jimg46/OAT_xtras/README.md

# OAT_xtras
OpenAstroTracker bits and pieces
