jimg46/OAT_xtras/OAT_xtras/barmount_v2.stl

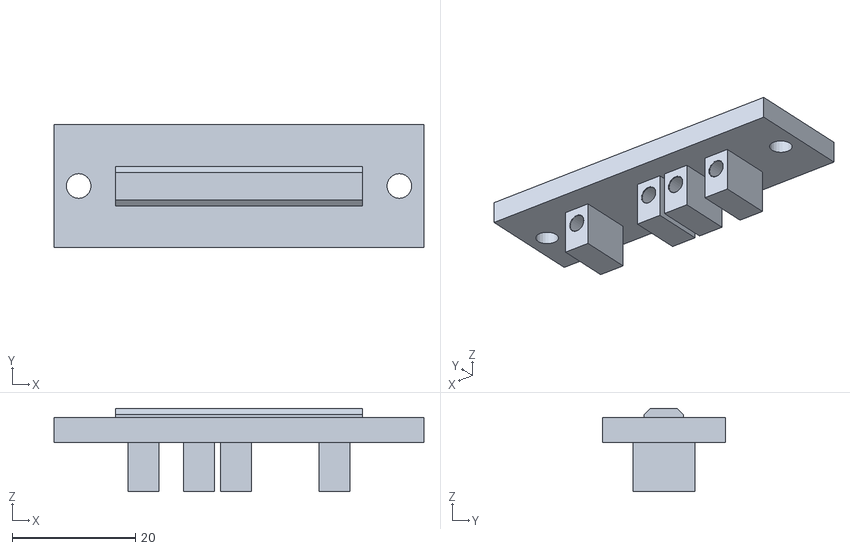
[picture p1: CAD file, 2021-03-11]
OAT_xtras/barmount_v2.stl
60.0 x 20.0 x 13.5
