jimg46/OAT_xtras/OAT_xtras/2020parallel_level.stl

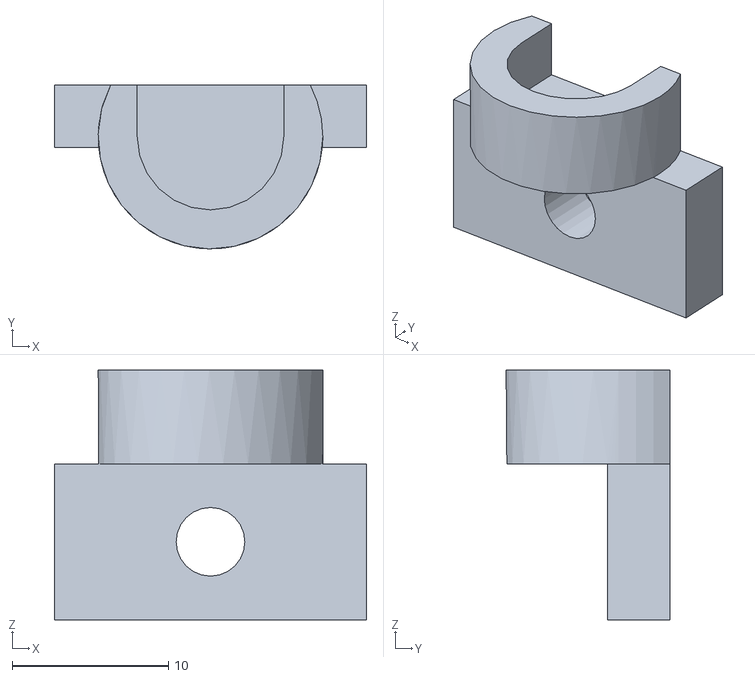
[picture p2: CAD file, 2021-03-11]
OAT_xtras/2020parallel_level.stl
20.0 x 10.5 x 16.0
