jimg46/OAT_xtras/OAT_xtras/RAstop.stl

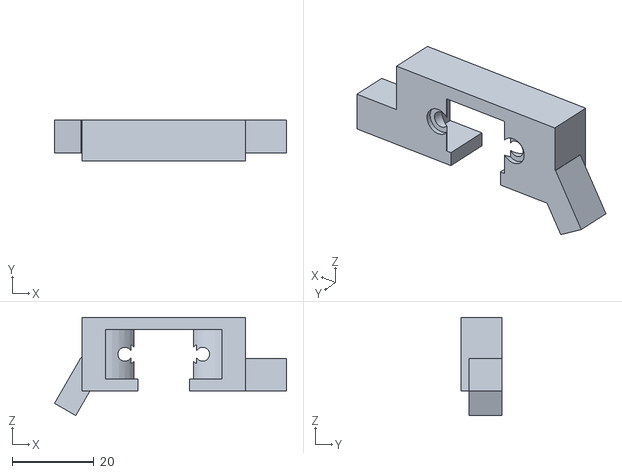
[picture p3: CAD file, 2021-03-11]
OAT_xtras/RAstop.stl
56.7 x 10.0 x 24.0
