jimg46/OAT_xtras/OAT_xtras/2020cross_level.stl

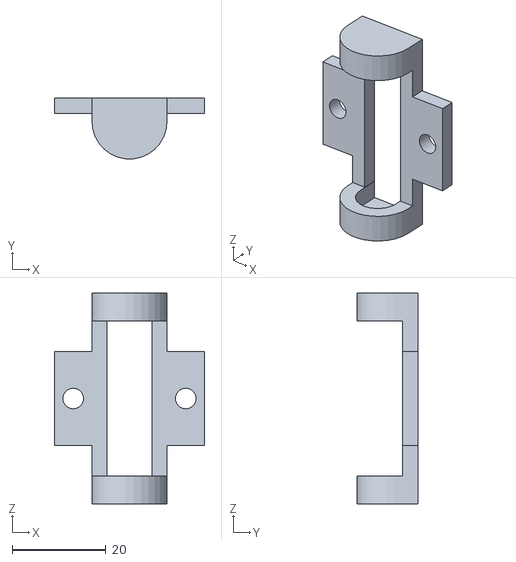
[picture p4: CAD file, 2021-03-11]
OAT_xtras/2020cross_level.stl
32.0 x 13.0 x 45.0
