jimg46/OAT_xtras/OAT_xtras/DEC_stop_arm.stl

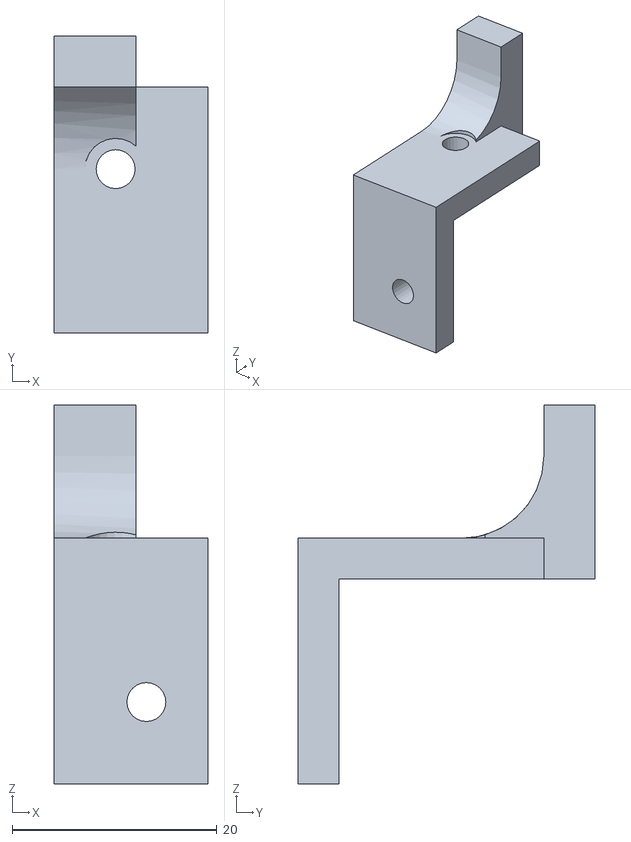
[picture p5: CAD file, 2021-03-11]
OAT_xtras/DEC_stop_arm.stl
15.0 x 29.0 x 37.0
