jimg46/OAT_xtras/EAGLE/ESPOAT.brd

## EAGLE design EAGLE/ESPOAT.brd (2021-03-11)

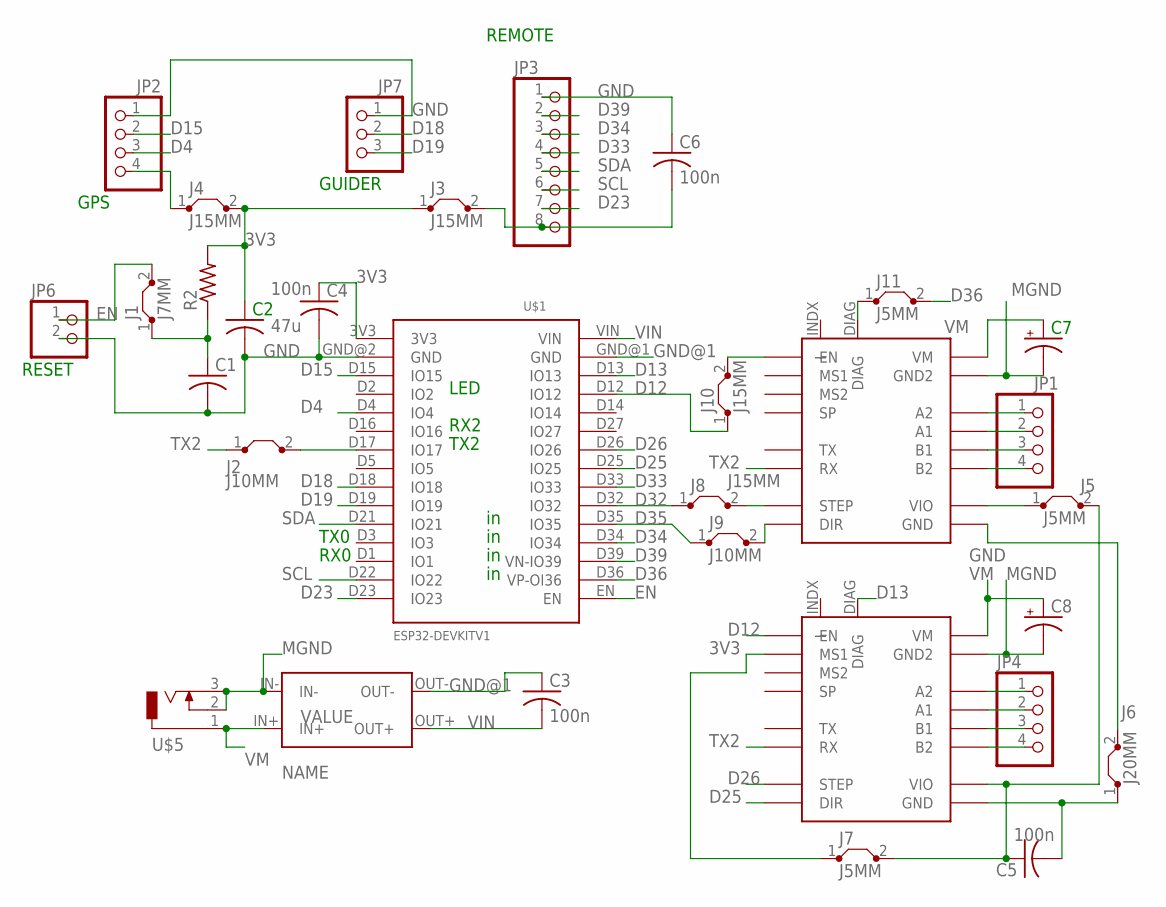
[picture p6: schematic ESPOAT.sch]

Parts:
C1: C-US025-030X050; C025-030X050
C2: 47u; C050-024X044
C3, C4, C5, C6: 100n; C050-024X044
C7, C8: CPOL-USE5-8.5; E5-8,5
J1: J7MM; 07
J2, J9: J10MM; 10
J3, J4, J8, J10: J15MM; 15
J5, J7, J11: J5MM; 05
J6: J20MM; 20
JP1, JP2, JP4: PINHD-1X4; 1X04
JP3: PINHD-1X8; 1X08
JP6: PINHD-1X2; 1X02
JP7: PINHD-1X3; 1X03
R2: R-US_0207/10; 0207/10
U$1: ESP32DEVKITV1; ESP32-DEVKITV1
U$2, U$3: FY2209V3
U$4: MINI-360
U$5: PS0520; DCJ0203

Connections:
3V3: C2.1, C4.1, J3.1, J4.2, J7.1, R2.2, U$1.3V3, U$3.MS1
D4: JP2.3, U$1.D4 (IO4)
D12: J10.1, U$1.D12 (IO12), U$3.EN
D13: U$1.D13 (IO13), U$3.DIAG
D15: JP2.2, U$1.D15 (IO15)
D18: JP7.2, U$1.D18 (IO18)
D19: JP7.3, U$1.D19 (IO19)
D23: JP3.7, U$1.D23 (IO23)
D25: U$1.D25 (IO25), U$3.DIR
D26: U$1.D26 (IO26), U$3.STP (STEP)
D32: J8.1, U$1.D32 (IO32)
D33: JP3.4, U$1.D33 (IO33)
D34: JP3.3, U$1.D34 (IO34)
D35: J9.1, U$1.D35 (IO35)
D36: J11.2, U$1.D36 (VP-OI36)
D39: JP3.2, U$1.D39 (VN-IO39)
EN: J1.2, JP6.1, U$1.EN
GND: C1.2, C2.2, C4.2, C6.1, J6.2, JP2.1, JP3.1, JP6.2, JP7.1, U$1.GND@2 (GND), U$2.GND
GND@1: C3.1, U$1.GND@1 (GND), U$4.OUT-
MGND: C7.-, C8.-, U$2.GND2, U$3.GND2, U$4.IN-, U$5.2, U$5.3
unnamed: JP1.4, U$2.B2
unnamed: J8.2, U$2.STP (STEP)
unnamed: C1.1, J1.1, R2.1
unnamed: J2.2, U$1.D17 (IO17)
unnamed: JP1.3, U$2.B1
unnamed: C5.1, J5.2, J7.2, U$3.VIO
unnamed: J4.1, JP2.4
unnamed: J5.1, U$2.VIO
unnamed: C5.2, J6.1, U$3.GND
unnamed: J9.2, U$2.DIR
unnamed: J10.2, U$2.EN
unnamed: JP1.2, U$2.A1
unnamed: JP1.1, U$2.A2
unnamed: JP4.1, U$3.A2
unnamed: JP4.2, U$3.A1
unnamed: JP4.3, U$3.B1
unnamed: JP4.4, U$3.B2
unnamed: J11.1, U$2.DIAG
unnamed: C6.2, J3.2, JP3.8
SCL: JP3.6, U$1.D22 (IO22)
SDA: JP3.5, U$1.D21 (IO21)
TX2: J2.1, U$2.RX, U$3.RX
VIN: C3.2, U$1.VIN, U$4.OUT+
VM: C7.+, C8.+, U$2.VM, U$3.VM, U$4.IN+, U$5.1

Notes on the sheet:
LED
TX0
RX0
REMOTE
GPS
RESET
GUIDER
TX2
RX2

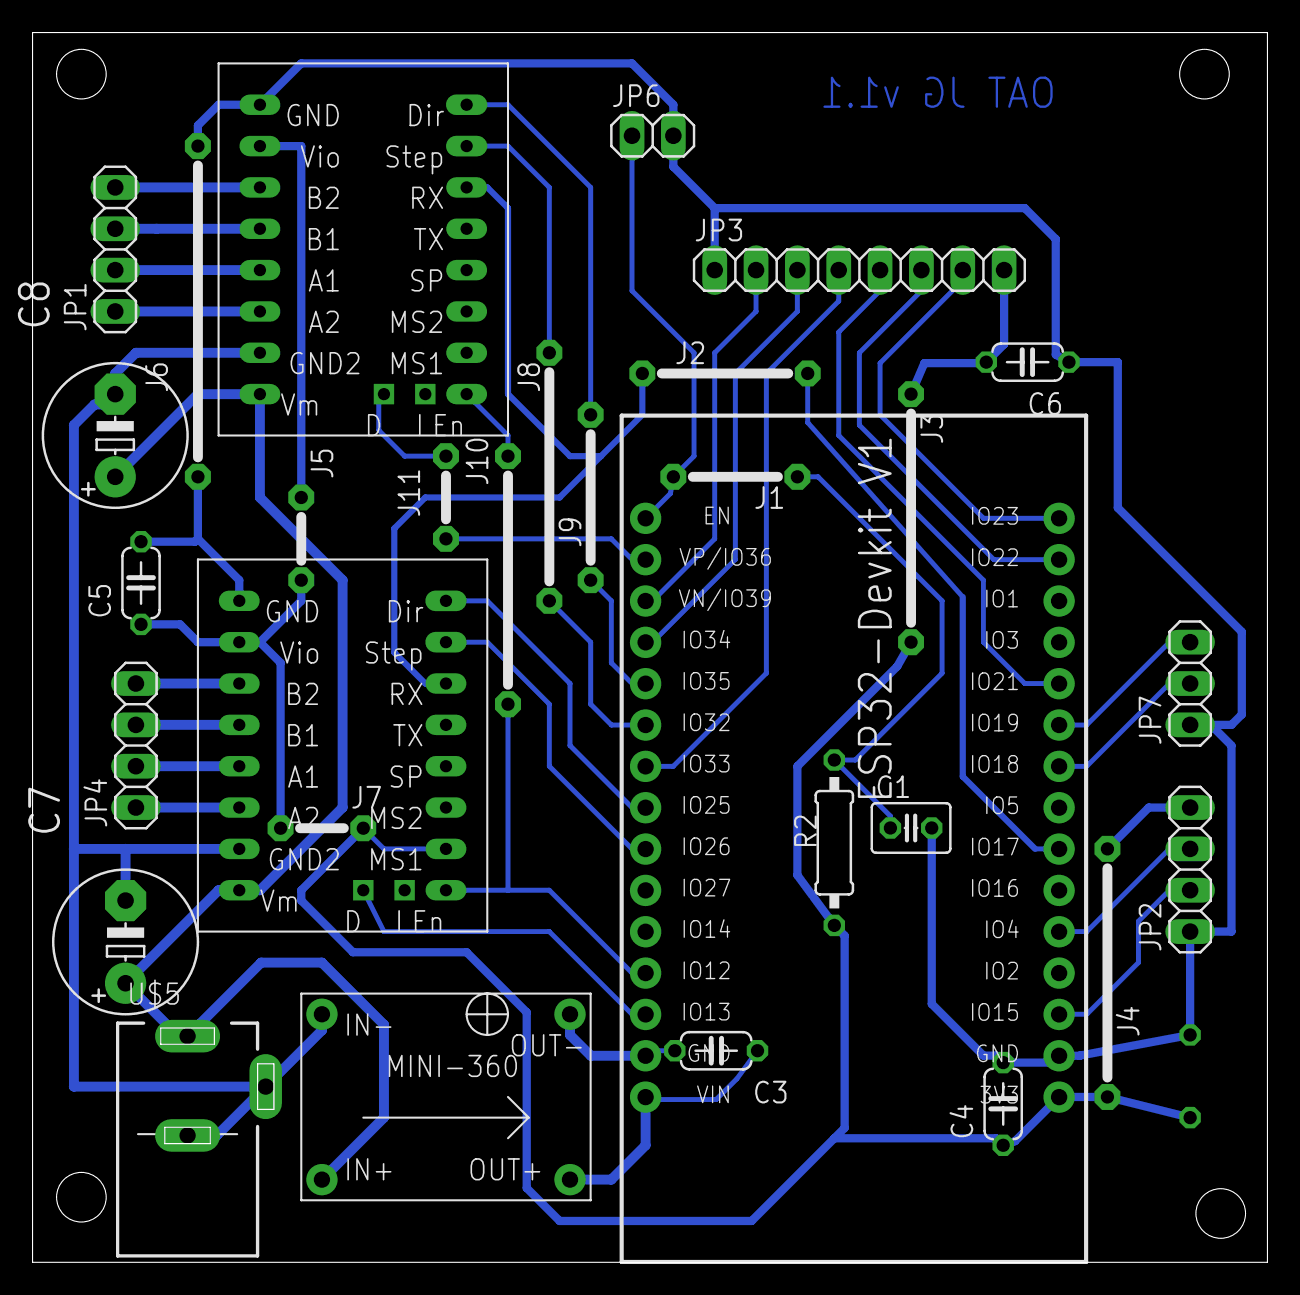
[picture p7: board ESPOAT.brd from above]

Board: 2 copper layers, 75.9 x 75.6 mm, 31 parts (1 on the bottom side), 44 nets.
